mar0x/midi_splitter/images/midi_splitter.jpg

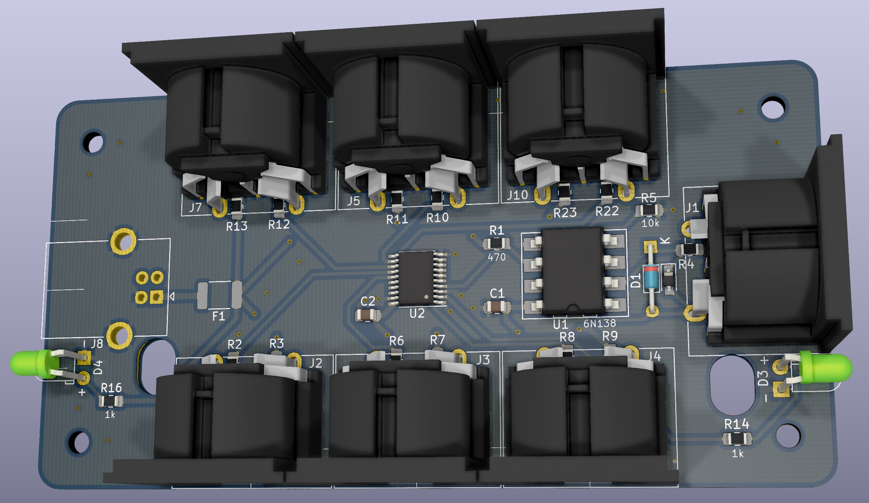
images/midi_splitter.jpg
