mar0x/midi_splitter/box/side_mill.jpg

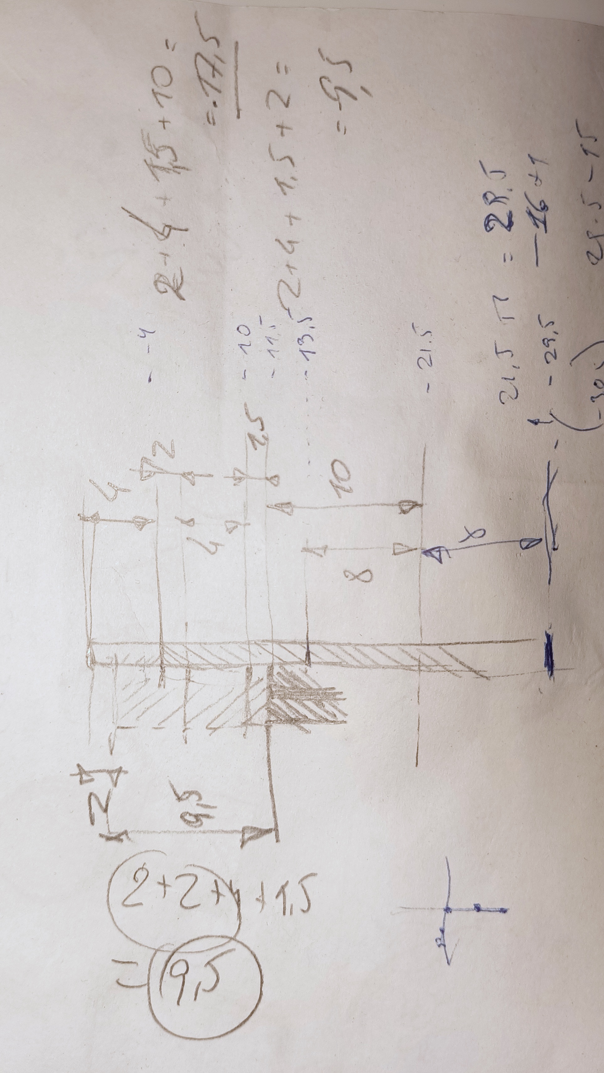
box/side_mill.jpg
