mar0x/midi_splitter/midi_splitter-bom.xlsx

Sheet: x6
id | q | ref | desc | size | Vendor |  | Order info
 |  |  |  |  | URL | code | # | date | price | count | shipping | cost | cost per item
G1032BA | 1 |  | Корпус для РЭА 101х54х41.7мм, пластик, черный, алюминиевая панель | 101х54х41.7mm | G1032BA (https://www.terraelectronica.ru/product/60026) | #60026 (https://www.terraelectronica.ru/product/60026) |  |  | 86.36 | 11 |  | 949.96 | 86.36
DS-210 | 0 | J6 | Гнездо питания 2,1х5,5мм на панель |  | DS-210B PBT NB (https://www.terraelectronica.ru/product/2584473) | #2584473 (https://www.terraelectronica.ru/product/2584473) |  |  | 10.40 | 10 | 322.00 | 426.00 | 0.00
 | 1 |  | Гнездо питания 2,0х5,5мм на панель |  | L-KLS1-DC-005A-2.0 (https://www.terraelectronica.ru/product/2200638) | #2200638 (https://www.terraelectronica.ru/product/2200638) |  |  | 6.30 | 10 |  | 63.00 | 6.30
DB102 | 1 | D2 | Диодный мост |  | DB102 (https://www.terraelectronica.ru/product/247793) | #247793 (https://www.terraelectronica.ru/product/247793) |  |  | 6.20 | 10 |  | 62.00 | 6.20
L7805 | 1 | U3 | Регулятор 5В, 1.5А | TO-220 | L7805 (https://www.terraelectronica.ru/product/62528) | #62528 (https://www.terraelectronica.ru/product/62528) |  |  | 12.70 | 10 |  | 127.00 | 12.70
SS-16-22 |  | C7 | Конд.эл. 22мкф 16В 4x7мм | 4x7mm | SS-16-22 (https://www.danomsk.ru/shop/5-kondensatory/88-kondensatory-elektroliticheskie/71209-ss-16-22-ss016m0022b1f-0407-4-7-16v-22uf-105-s-yageo/) | #71209 (https://www.danomsk.ru/shop/5-kondensatory/88-kondensatory-elektroliticheskie/71209-ss-16-22-ss016m0022b1f-0407-4-7-16v-22uf-105-s-yageo/) |  |  | 1.60 | 1 |  | 1.60 | 0.00
1N914 | 1 | D1 | Диод 75 мА 75В 5нс | DO-35 | 1N914 (https://www.terraelectronica.ru/product/284453) | #284453 (https://www.terraelectronica.ru/product/284453) |  |  | 0.56 | 10 |  | 5.60 | 0.56
6N138M | 1 | U1 | Оптопара с транзисторным выходом | SMD DIP-8 | 6N138M (https://www.aliexpress.com/item/10pcs-lot-6N135-6N136-6N137-6N138-6N139-DIP-8-SMD-8/32874392571.html) |  | #5009650439222510 (https://trade.aliexpress.ru/order_detail.htm?orderId=5009650439222510&orderSource=GlobalTrade) | 2021-04-05 | 9.85 | 20 | 199.27 | 396.19 | 19.81
74HC14 | 1 | U2 | Инвертирующий Триггер Шмитта | SOIC-14 | 74HC14D (https://www.terraelectronica.ru/product/34128) | #34128 (https://www.terraelectronica.ru/product/34128) |  |  | 6.60 | 10 |  | 66.00 | 6.60
RTW909080M | 7 | J1,J2,J3,J4,J5,J7,J10 | DIN connector 5 Pin DIN Female Jack Right Angle Panel Mount 90 Degree |  | DS-5-01 (https://aliexpress.ru/item/32402564814.html) |  | #5009651953842510 (https://trade.aliexpress.ru/order_detail.htm?orderId=5009651953842510&orderSource=GlobalTrade) | 2021-04-05 | 6.22 | 70 | 678.95 | 1114.49 | 111.45
PCB | 1 |  |  |  | JLCPCB |  |  |  | 38.17 | 10 | 556.52 | 938.22 | 93.82
220 Ohm | 13 | R2,R3,R4,R6,R7,R8,R9,R10,R11,R12,R13,R22,R23 | Чип резистор, 0.125Вт, 220 Ом, 1% | 0805 | CR-05FL7--220R (https://www.terraelectronica.ru/product/2782271) | #2782271 (https://www.terraelectronica.ru/product/2782271) |  |  | 0.13 | 130 |  | 16.90 | 1.69
470 Ohm | 1 | R1 | Чип резистор, 0.125Вт, 470 Ом, 1% | 0805 | CR-05FL7--470R (https://www.terraelectronica.ru/product/2782319) | #2782319 (https://www.terraelectronica.ru/product/2782319) |  |  | 0.13 | 10 |  | 1.30 | 0.13
10 kOhm | 3 | R5 | Чип резистор, 0.125Вт, 10 кОм, 1% | 0805 | RC0805FR-0710KL (https://www.terraelectronica.ru/product/358763) | #358763 (https://www.terraelectronica.ru/product/358763) |  |  | 0.17 | 30 |  | 5.10 | 0.51
1 kOhm | 3 | R14,R15,R16 | Чип резистор, 0.125Вт, 1 кОм, 1% | 0805 | CR0805-FX-1001ELF (https://www.terraelectronica.ru/product/813964) | #813964 (https://www.terraelectronica.ru/product/813964) |  |  | 0.28 | 30 |  | 8.40 | 0.84
0.1 uF | 5 | C1,C2,C4,C5,C6 | Кер.ЧИП конд. 0.1 мкФ, X7R, 50В, 10% | 0805 | CL21B104KBCNNNC (https://www.terraelectronica.ru/product/817075) | #817075 (https://www.terraelectronica.ru/product/817075) |  |  | 0.53 | 100 |  | 53.00 | 2.65
0.33uF | 1 | C3 | Кер.ЧИП конд. 0.33 мкФ, X7R, 50В, 10% | 0805 | CL21B334KBFNNNE (https://www.terraelectronica.ru/product/863571) | #863571 (https://www.terraelectronica.ru/product/863571) |  |  | 0.76 | 10 |  | 7.60 | 0.76
MF-MSMF050-2 | 1 | F1 | PTC Resettable Fuse | 1812 | MF-MSMF050-2 (https://www.terraelectronica.ru/product/186713) | #186713 (https://www.terraelectronica.ru/product/186713) |  |  | 2.30 | 10 |  | 23.00 | 2.30
DS1099 | 1 | J8 | USB Type-B |  | USBB-1J (https://www.terraelectronica.ru/product/2259339) | #2259339 (https://www.terraelectronica.ru/product/2259339) |  |  | 5.10 | 10 |  | 51.00 | 5.10
Micro USB | 1 | J9 | Micro USB Type-B |  | 10118194-0001LF (https://www.terraelectronica.ru/product/2543224) | #2543224 (https://www.terraelectronica.ru/product/2543224) |  |  | 20.00 | 1 |  | 20.00 | 20.00
PMV65XP,215 | 2 | Q2,Q3 | Транзистор MOSFET P-CH 20V 3.9A 76 mOhm | SOT-23-3 | PMV65XP.215 (https://www.terraelectronica.ru/product/212641) | #212641 (https://www.terraelectronica.ru/product/212641) |  |  | 3.20 | 20 |  | 64.00 | 6.40
SN74LVC1G125DBVR | 1 | U4 | Один буферный элемент с тремя состояниями на выходе | SOT-23-5 | SN74LVC1G125 (https://www.terraelectronica.ru/product/32503) | #32503 (https://www.terraelectronica.ru/product/32503) |  |  | 2.60 | 10 |  | 26.00 | 2.60
BC817 | 1 | Q1 | Транзистор биполярный NPN | SOT-23 | BC817.215 (https://www.terraelectronica.ru/product/338618) | #338618 (https://www.terraelectronica.ru/product/338618) |  |  | 0.88 | 10 |  | 8.80 | 0.88
100 kOhm | 1 | R21 | Чип резистор, 0.125Вт, 100 кОм, 1% | 0805 | RC0805FR-07100KL (https://www.terraelectronica.ru/product/359706) | #359706 (https://www.terraelectronica.ru/product/359706) |  |  | 0.18 | 20 |  | 3.60 | 0.18
 |  |  |  |  |  |  |  |  |  |  | 1756.74 | 4435.16 | 387.66

Sheet: x6-2
id | q | ref | desc | size | Vendor |  | Order info
 |  |  |  |  | URL | code | # | date | price | count | shipping | cost | cost per item
G1032BA | 1 |  | Корпус для РЭА 101х54х41.7мм, пластик, черный, алюминиевая панель | 101х54х41.7mm | G1032BA (https://www.terraelectronica.ru/product/60026) | #60026 (https://www.terraelectronica.ru/product/60026) | #07863451 (https://www.terraelectronica.ru/order/07863451) | 2022-03-22 | 224.00 | 21 |  | 4704.00 | 224.00
1N914 | 1 | D1 | Диод 75 мА 75В 5нс | DO-35 | 1n914 (https://www.chipdip.ru/product/1n914) |  | #8341083 (https://www.chipdip.ru/order/detail/8341083) | 2022-03-22 | 14.00 | 20 |  | 280.00 | 14.00
6N138M | 1 | U1 | Оптопара с транзисторным выходом | SMD DIP-8 |  | #32874392571 (https://www.aliexpress.ru/item/32874392571.html) | #5017385647722510 (https://trade.aliexpress.ru/order_detail.htm?orderId=5017385647722510&orderSource=GlobalTrade) | 2022-03-05 | 17.75 | 20 | 99.52 | 454.56 | 22.73
MM74HC540MTCX | 1 | U2 | Восемь буферных элементов, драйверов с тремя состояниями на выходе | TSSOP-20 | mm74hc540mtcx (https://www.chipdip.ru/product/mm74hc540mtcx) |  | #8338098 (https://www.chipdip.ru/order/detail/8338098) | 2022-03-21 | 26.00 | 21 |  | 546.00 | 26.00
RTW909080M | 7 | J1,J2,J3,J4,J5,J7,J10 | DIN connector 5 Pin DIN Female Jack Right Angle Panel Mount 90 Degree |  |  | #1005002547515126 (https://www.aliexpress.ru/item/1005002547515126.html) | #5017461801272510 (https://trade.aliexpress.ru/order_detail.htm?orderId=5017461801272510&orderSource=GlobalTrade) | 2022-03-14 | 22.02 | 300 | 1711.62 | 8316.43 | 194.05
PCB | 1 |  |  |  | Rezonit |  | #1517354 (https://service.rezonit.ru/orders/1168288) | 2022-03-22 |  | 20 |  | 7624.08 | 381.20
220 Ohm | 13 | R2,R3,R4,R6,R7,R8,R9,R10,R11,R12,R13,R22,R23 | Чип резистор, 0.125Вт, 220 Ом, 1% | 0805 | CR-05FL7--220R (https://www.terraelectronica.ru/product/2782271) | #2782271 (https://www.terraelectronica.ru/product/2782271) | #07863451 (https://www.terraelectronica.ru/order/07863451) | 2022-03-22 | 0.25 | 800 |  | 200.00 | 3.25
470 Ohm | 1 | R1 | Чип резистор, 0.125Вт, 470 Ом, 1% | 0805 | CR-05FL7--470R (https://www.terraelectronica.ru/product/2782319) | #2782319 (https://www.terraelectronica.ru/product/2782319) | #07863451 (https://www.terraelectronica.ru/order/07863451) | 2022-03-22 | 0.25 | 400 |  | 100.00 | 0.25
10 kOhm | 1 | R5 | Чип резистор, 0.125Вт, 10 кОм, 1% | 0805 | RC0805FR-0710KL (https://www.terraelectronica.ru/product/358763) | #358763 (https://www.terraelectronica.ru/product/358763) | #07863451 (https://www.terraelectronica.ru/order/07863451) | 2022-03-22 | 0.32 | 100 |  | 32.00 | 0.32
1 kOhm | 2 | R14,R16 | Чип резистор, 0.125Вт, 1 кОм, 1% | 0805 | CR0805-FX-1001ELF (https://www.terraelectronica.ru/product/813964) | #564131 (https://www.terraelectronica.ru/product/564131) | #07863451 (https://www.terraelectronica.ru/order/07863451) | 2022-03-22 | 0.28 | 30 |  | 8.40 | 0.56
0.1 uF | 2 | C1,C2 | Кер.ЧИП конд. 0.1 мкФ, X7R, 50В, 10% | 0805 | CC0805KRX7R9BB104 (https://www.terraelectronica.ru/product/251110) | #251110 (https://www.terraelectronica.ru/product/251110) | #07863451 (https://www.terraelectronica.ru/order/07863451) | 2022-03-22 | 0.66 | 400 |  | 264.00 | 1.32
L-13GD | 1 | D3 | Светодиод Flat Top зеленый 70° d=2мм 10мКд 568нМ |  | L-13GD (https://www.chipdip.ru/product/l-13gd) |  | #8341104 (https://www.chipdip.ru/order/detail/8341104) | 2022-03-22 | 29.00 | 70 |  | 2030.00 | 29.00
L-13ID | 1 | D4 | Flat Top красный |  |  | #307856 (https://www.terraelectronica.ru/product/307856) | #07863451 (https://www.terraelectronica.ru/order/07863451) | 2022-03-22 | 9.80 | 3 |  | 29.40 | 9.80
DS1099 | 1 | J8 | USB Type-B |  |  | #3638121 (https://www.terraelectronica.ru/product/3638121) | #07863451 (https://www.terraelectronica.ru/order/07863451) | 2022-03-22 | 11.30 | 40 |  | 452.00 | 11.30
MF-MSMF050-2 | 1 | F1 | PTC Resettable Fuse | 1812 |  | #4000903717748 (https://www.aliexpress.ru/item/4000903717748.html) |  | 2022-03-22 | 9.71 | 60 | 245.58 | 828.21 | 13.80
 |  |  |  |  |  |  |  |  |  |  | 2056.72 | 25869.08 | 931.59

Sheet: Orders
name | q | vendor | order date | order id | price | shipping | payment
PCB | 10 | jlcpcb.com | 2021-01-21 | #Y31-2346369A | 369.06 | 538.09 | 907.15
DS-5-01 MIDI | 70 | aliexpress.com | 2021-01-19 | #5008164770252510 (https://trade.aliexpress.ru/order_detail.htm?orderId=5008164770252510) | 1603.88 | 153.77 | 1757.65
6N138 SMD | 10 | aliexpress.com | 2021-01-19 | #5008164770232510 (https://trade.aliexpress.ru/order_detail.htm?orderId=5008164770232510) | 95.15 | 192.59 | 287.74
 |  | terraelectronica.ru | 2021-01-20 | #07251713 (https://www.terraelectronica.ru/order/07251713) | 1660.3 | 322 | 1982.3
total | 10 |  |  |  | 3728.39 | 1206.45 | 4934.84
PCB | 10 | jlcpcb.com | 2021-04-05 | #Y31-2346369A | 381.7 | 556.52 | 938.22
DS-5-01 MIDI | 70 | aliexpress.com | 2021-04-05 | #5009651953842510 (https://trade.aliexpress.ru/order_detail.htm?orderId=%205009651953842510) | 435.54 | 678.95 | 1114.49
6N138 SMD | 20 | aliexpress.com | 2021-04-05 | #5009650439222510 (https://trade.aliexpress.ru/order_detail.htm?orderId=%205009650439222510) | 196.92 | 199.27 | 396.19
 |  | terraelectronica.ru | 2021-04-05 | #07361016 (https://www.terraelectronica.ru/order/07361016) | 1739.24 | 322 | 2061.24
total | 10 |  |  |  | 2753.4 | 1756.74 | 4510.14
PCB | 10 | jlcpcb.com | 2022-02-01 | #Y31-2346369A | 387.29 | 549.18 | 936.47
DS-5-01 MIDI | 100 | aliexpress.com | 2022-02-01 | #5016623841712510 (https://trade.aliexpress.ru/order_detail.htm?orderId=5016623841712510&orderSource=GlobalTrade) | 797.1 | 590.3 | 1387.4
 |  | terraelectronica.ru | 2022-02-22 | #07796164 (https://www.terraelectronica.ru/order/07796164) | 505.44 | 236 | 741.44
 |  | terraelectronica.ru | 2022-02-25 | #07831475 (https://www.terraelectronica.ru/order/07831475) | 505.92 | 236 | 741.92
total | 10 |  |  |  | 1689.83 | 1611.48 | 3807.23
6N138M | 20 | aliexpress.com | 2022-03-05 | #5017385647722510 (https://trade.aliexpress.ru/order_detail.htm?orderId=5017385647722510&orderSource=GlobalTrade) | 355.04 | 99.52 | 454.56
DS-5-01 | 300 | aliexpress.com | 2022-03-14 | #5017461801272510 (https://trade.aliexpress.ru/order_detail.htm?orderId=5017461801272510&orderSource=GlobalTrade) | 6604.81 | 1711.62 | 8316.43
 |  | chipdip.ru | 2022-03-21 | #8338098 (https://www.chipdip.ru/order/detail/8338098) | 651 |  | 651
PCB | 20 | rezonit.ru | 2022-03-22 | #1517354 (https://service.rezonit.ru/orders/1168288) |  |  | 7624.08
 |  | chipdip.ru | 2022-03-22 | #8341083 (https://www.chipdip.ru/order/detail/8341083) | 4430 |  | 4430
 |  | terraelectronica.ru | 2022-03-22 | #07863451 (https://www.terraelectronica.ru/order/07863451) | 10778.4 | 236 | 11014.4
L-13GD | 70 | chipdip.ru | 2022-03-22 | #8341104 (https://www.chipdip.ru/order/detail/8341104) | 2030 |  | 2030
MF-MSMF050-2 | 60 | aliexpress.com | 2022-03-22 | #4000903717748 (https://www.aliexpress.ru/item/4000903717748.html) | 582.63 | 245.58 | 828.21
 |  |  |  |  |  |  | 35348.68
