mar0x/midi_splitter/kicad/power_adapter/power_adapter.step

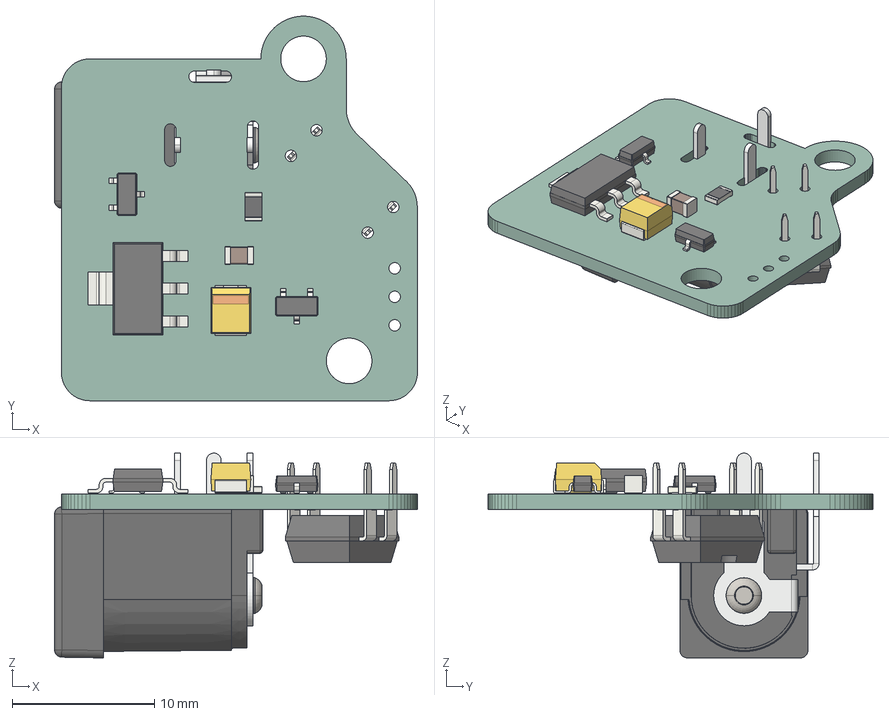
[picture p3: CAD file, 2024-02-03]
kicad/power_adapter/power_adapter.step
25.5 x 27.0 x 14.4 mm
SOT_223
SOT_23 x 2
C_0805_2012Metric
CP_EIA_3528_21_Kemet_B
R_0805_2012Metric
DIP-4_W7.62mm
DC Power Jack 5.5mm x 2.1mm
power_adapter PCB
