mar0x/midi_splitter/(threads)

Thread 1 (2021-12-07):

74AUC1G125 usage bug

DrAleks40, 2021-12-07:
В схеме использована 74AUC1G125 при питании +5В. Штатное питание этого чипа ВДВОЕ ниже, максимально допустимое 3.6V! Схема рабочая вообще???

DrAleks40, 2021-12-07:
Может просто отказаться от 5-6 каналов и пару элементов с 74HC14D пустить вместо 74AUC1G125???

mar0x, 2021-12-07:
Здравствуйте.
Это опечатка в схеме. Используется SN74LVC1G125. В [midi_splitter-bom.xlsx](https://github.com/mar0x/midi_splitter/blob/master/midi_splitter-bom.xlsx) указан правильный номинал.

Схему поправлю. Спасибо!

DrAleks40, 2021-12-07:
Ну или просто вместо SN74LVC1G125 поставить еще одну 74HC14D в режиме повторителя с упятеренным выходом? Дешевле кстати.

DrAleks40, 2021-12-07:
И еще попутно вопрос. Оптрон на AOT127 заменить можно? С изменением цоколевки ессно.

mar0x, 2021-12-07:
> Оптрон на AOT127 заменить можно?
Почитал [харктеристики](https://www.kondratev-v.ru/uploads_PDF/AOT127-AOT128/AOT127-AOT128.pdf). Судя по ограничению 1.6 В и задержке 10 мкс - нельзя.

mar0x, 2021-12-07:
Чем меньше, тем лучше. Важно, чтобы она не сильно отличалась на фронтах иначе будет искажение сигнала. MIDI передаётся на скорости 31250 bit/s т.е. 1 bit - 32 мкс. Разные устройства допускают различные отклонения (где-то 10%).
6N138 добавляет 1-2 мкс на восходящем фронте, на спадающем - меньше. Лучше переходить на 6N137 - он быстрее.

DrAleks40, 2021-12-07:
Хорошо, спасибо. Вместо SN74LVC1G125 поставить еще одну 74HC14D в режиме повторителя с упятеренным выходом можно?

mar0x, 2021-12-07:
Можно. Берите тогда сразу инвертированный сигнал с 8й ноги U2 - будет сразу ушестиритель. Царь-сплиттер на 11 выходов!

DrAleks40, 2021-12-07:
> с 8й ноги U2 - будет сразу ушестиритель.

Упс... А в чем тогда смысл канала на SN74LVC1G125, если JP1 не использовать?

mar0x, 2021-12-07:
Это доработка. Сначала был сплиттер x5, на свободное место добавили выход и буферный элемент. Этикетки "из старых запасов", их много напечатали не выбрасывать же... А джампер на случай, если будет сильное взаимное влияние и придётся поменять источник для U4 на выход из U2 (я не тестировал эту доработку до заказа платы).

DrAleks40, 2021-12-07:
Ясно. То есть от J10, U4 и т.п. можно вообще безболезненно отказаться. )) А вместо Q1 светодиод запитать от одного из выходов U2. )) Спасибо за разъяснения.

mar0x, 2022-05-10:
@DrAleks40 Приехали платы для упрощённой схемы "с одной микрухой и оптроном". Если интересно, могу продать комплект для сборки.

DrAleks40, 2022-05-10:
Интересно. Где глянуть эту вашу схему/плату? Почем комплект для сборки или одна голая плата?

Отправлено из мобильной Почты Mail.Ru

Вторник, 10 мая 2022 г., 12:18 +0300 от ***@***.***  ***@***.***>:
***@***.*** Приехали платы для упрощённой схемы "с одной микрухой и оптроном". Если интересно, могу продать комплект для сборки.
>—
>Reply to this email directly,  view it on GitHub , or  unsubscribe .
>You are receiving this because you were mentioned. Message ID:  <mar0x/midi_splitter/issues/1/1122140411 @ github . com>

mar0x, 2022-05-10:
Давайте перейдём в какой-нибудь мессенджер: +7 916 185-06-71

DrAleks40, 2022-05-10:
Не пользуюсь (кроме авито). В среду в какое время можете на коломенской или ближе к центру-северу? Я заранее позвоню тогда.

Отправлено из мобильной Почты Mail.Ru

Вторник, 10 мая 2022 г., 18:59 +0300 от ***@***.***  ***@***.***>:
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

mar0x, 2022-05-10:
В среду буду на Коломенской с 10:30 до 12:00. GitHub, мягко говоря, не для того подобных обсуждений. Ещё есть почта t79161850671@mail.ru.
Хотелось бы понять что Вас интересует (плата, весь набор и т.д.) шильдиков, напр. у меня сейчас нет.

Closed 2021-12-07.
