mar0x/midi_splitter/images/midi_splitter-pcb.pdf

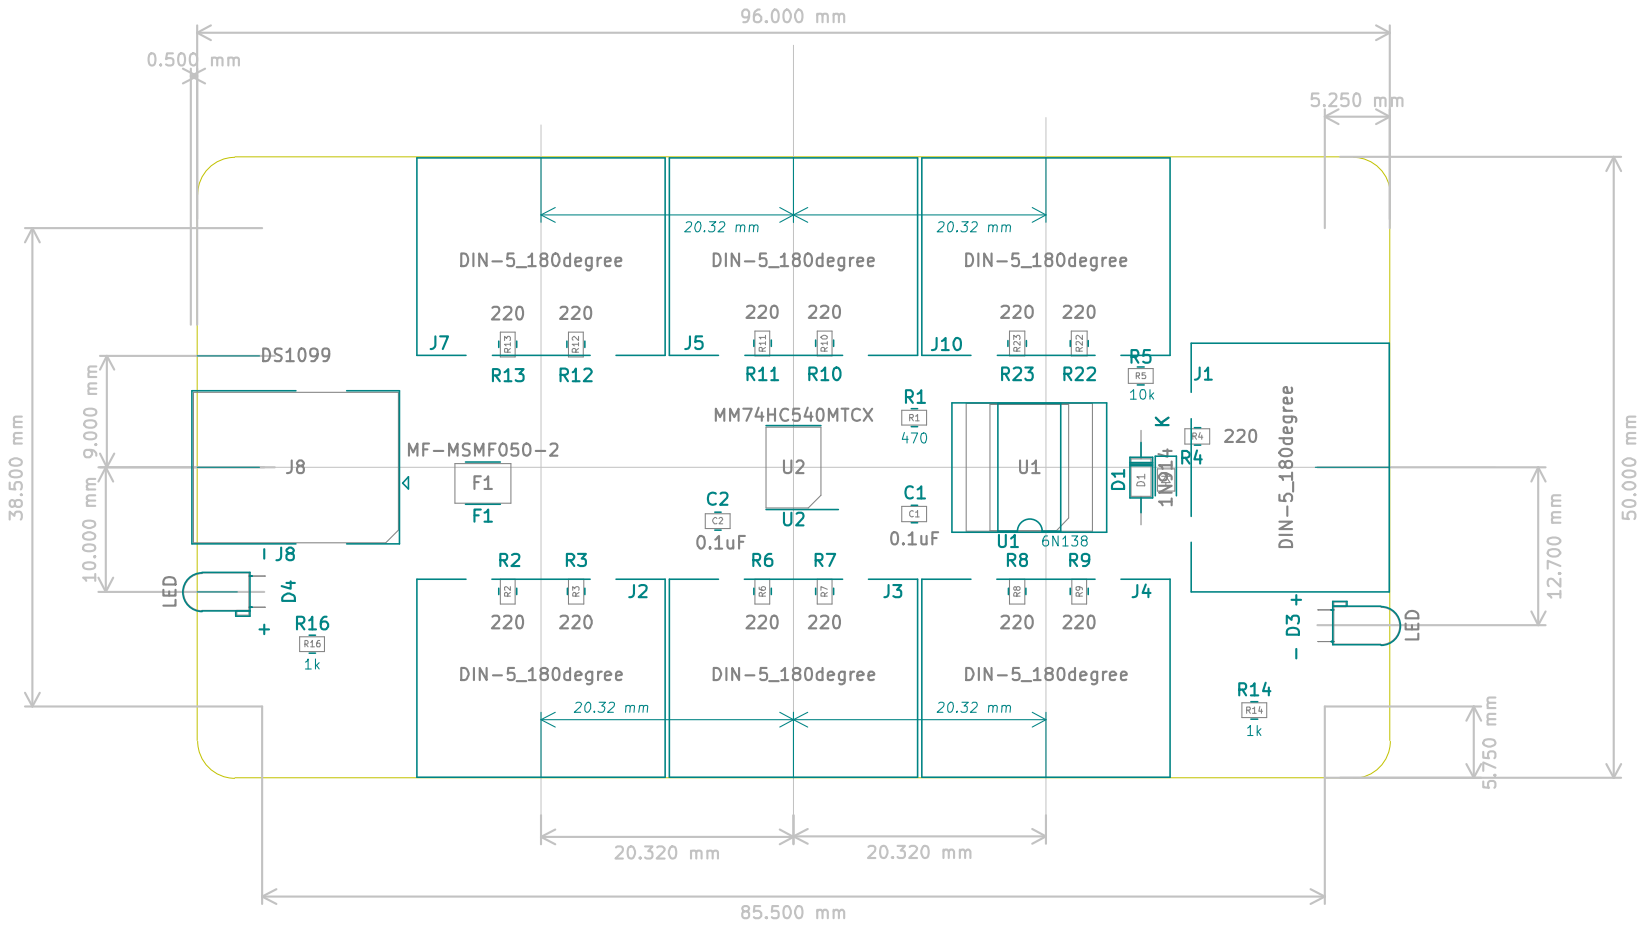
[picture p4: page 1]
