mar0x/midi_splitter/images/midi_splitter-schema.pdf

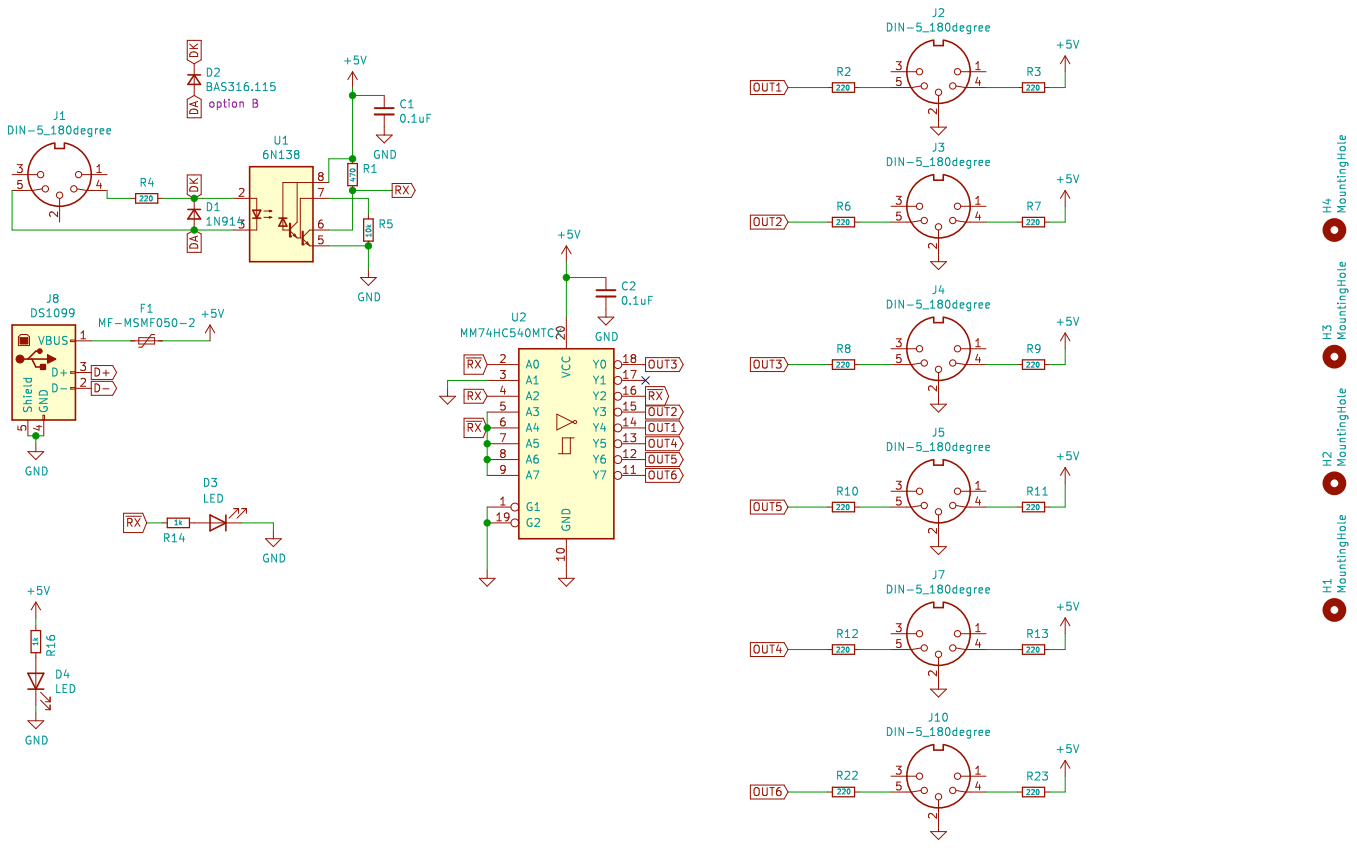
[picture p5: page 1]
