mar0x/midi_splitter/kicad/power_adapter/power_adapter.kicad_pcb

## KiCad design kicad/power_adapter/power_adapter.kicad_pcb (2024-02-12)

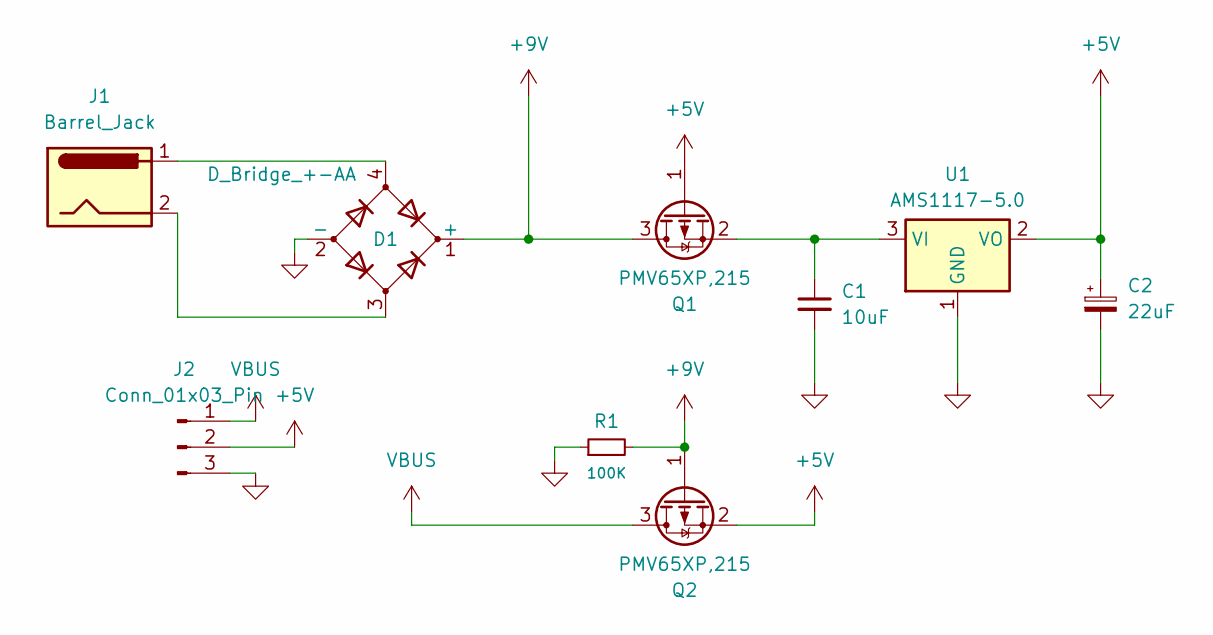
[picture p6: schematic power_adapter.kicad_sch]

Parts:
C1: 10uF; C_0805_2012Metric
C2: 22uF; CP_EIA-3528-21_Kemet-B
D1: D_Bridge_+-AA; Diode_Bridge_MBS
J1: Barrel_Jack; BarrelJack_Wuerth_6941xx301002
J2: Conn_01x03_Pin; PinHeader_1x03_P2.00mm_Vertical
Q1, Q2: PMV65XP,215; SOT-23
R1: 100K; R_0805_2012Metric
U1: AMS1117-5.0; SOT-223-3_TabPin2

Connections:
+5V: C2.1, J2.2, Q1.1 (G), Q2.2 (S), U1.2 (VO)
+9V: D1.1 (+), Q1.3 (D), Q2.1 (G), R1.2
GND: C1.2, C2.2, D1.2 (-), J2.3, R1.1, U1.1 (GND)
unnamed: D1.3, J1.2
unnamed: D1.4, J1.1
unnamed: C1.1, Q1.2 (S), U1.3 (VI)
VBUS: J2.1, Q2.3 (D)

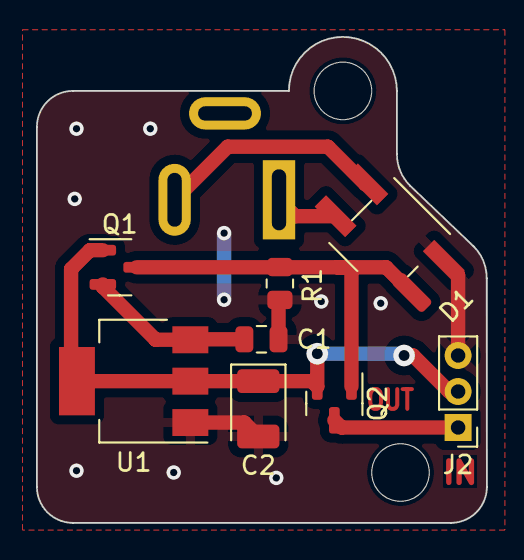
[picture p7: board power_adapter.kicad_pcb from above]

Board: 2 copper layers, 25.0 x 27.0 mm, 9 parts (1 on the bottom side), 7 nets.
