mar0x/midi_splitter/kicad/midi_splitter/midi_splitter.kicad_pcb

## KiCad design kicad/midi_splitter/midi_splitter.kicad_pcb (2024-02-03)

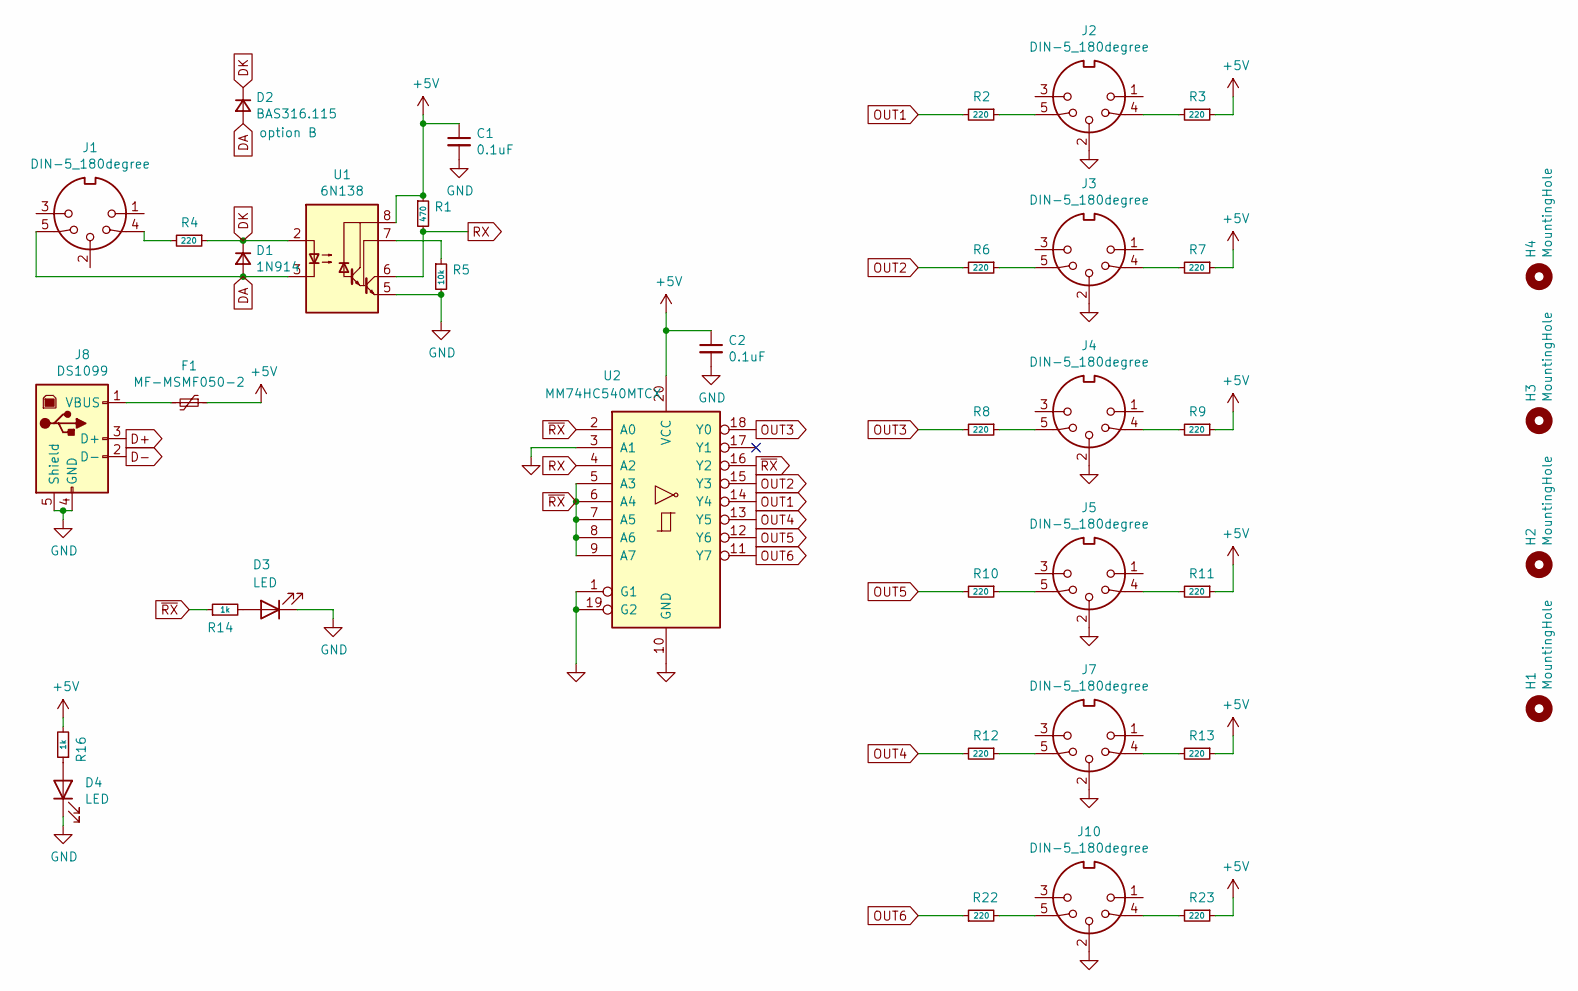
[picture p8: schematic midi_splitter.kicad_sch]

Parts:
C1, C2: 0.1uF; C_0805_2012Metric_Pad1.15x1.40mm_HandSolder
D1: 1N914; D_DO-34_SOD68_P7.62mm_Horizontal
D2: BAS316.115; D_SOD-323_HandSoldering
D3: LED; LED_D3.0mm_Horizontal_O1.27mm_Z10.0mm
D4: LED; LED_D3.0mm_Horizontal_O1.27mm_Z6.0mm
F1: MF-MSMF050-2; Fuse_1812_4532Metric_Pad1.30x3.40mm_HandSolder
H1, H2, H3, H4: MountingHole; MountingHole_2.7mm_M2.5_ISO14580
J1, J2, J3, J4, J5, J7, J10: DIN-5_180degree; DIN5MIDI-OOTDTY
J8: DS1099; USB_B_OST_USB-B1HSxx_Horizontal
R1: 470; R_0805_2012Metric_Pad1.15x1.40mm_HandSolder
R2, R3, R4, R6, R7, R8, R9, R10, R11, R12, R13: 220; R_0805_2012Metric_Pad1.15x1.40mm_HandSolder
R5: 10k; R_0805_2012Metric_Pad1.15x1.40mm_HandSolder
R14, R16: 1k; R_0805_2012Metric_Pad1.15x1.40mm_HandSolder
R22, R23: 220; R_0805_2012Metric_Pad1.20x1.40mm_HandSolder
U1: 6N138; DIP-8_W8.89mm_SMDSocket_LongPads
U2: MM74HC540MTCX; TSSOP-20_4.4x6.5mm_P0.65mm

Connections:
+5V: C1.1, C2.1, F1.1, R1.1, R3.1, R7.1, R9.1, R11.1, R13.1, R16.2, R23.1, U1.8 (VCC), U2.20 (VCC)
D+: J8.3 (D+)
D-: J8.2 (D-)
DA: D1.2 (A), D2.2 (A), J1.5, U1.3 (C2)
DK: D1.1 (K), D2.1 (K), R4.1, U1.2 (C1)
GND: C1.2, C2.2, D3.1 (K), D4.1 (K), J2.2, J3.2, J4.2, J5.2, J7.2, J8.4 (GND), J8.5 (Shield), J10.2, R5.2, U1.5 (GND), U2.1 (G1), U2.3 (A1), U2.10 (GND), U2.19 (G2)
unnamed: D3.2 (A), R14.2
unnamed: D4.2 (A), R16.1
unnamed: F1.2, J8.1 (VBUS)
unnamed: J1.4, R4.2
unnamed: J2.4, R3.2
unnamed: J2.5, R2.1
unnamed: J3.4, R7.2
unnamed: J3.5, R6.1
unnamed: J4.4, R9.2
unnamed: J4.5, R8.1
unnamed: J5.4, R11.2
unnamed: J5.5, R10.1
unnamed: J7.4, R13.2
unnamed: J7.5, R12.1
unnamed: J10.4, R23.2
unnamed: J10.5, R22.2
unnamed: R5.1, U1.7 (VO1)
OUT1: R2.2, U2.14 (Y4)
OUT2: R6.2, U2.15 (Y3)
OUT3: R8.2, U2.18 (Y0)
OUT4: R12.2, U2.13 (Y5)
OUT5: R10.2, U2.12 (Y6)
OUT6: R22.1, U2.11 (Y7)
RX: R1.2, U1.6 (VO2), U2.4 (A2)
~RX: R14.1, U2.2 (A0), U2.5 (A3), U2.6 (A4), U2.7 (A5), U2.8 (A6), U2.9 (A7), U2.16 (Y2)

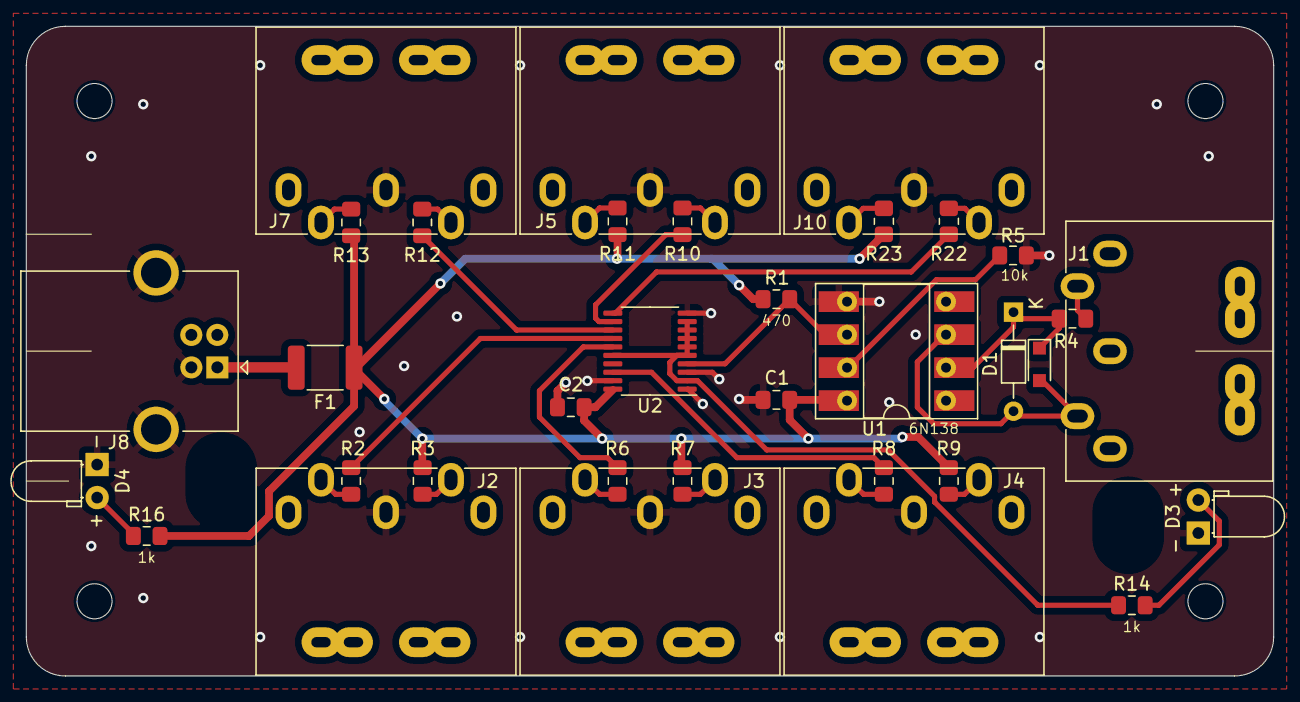
[picture p9: board midi_splitter.kicad_pcb from above]

Board: 2 copper layers, 96.0 x 50.0 mm, 38 parts (0 on the bottom side), 29 nets.
