mar0x/midi_splitter/(commit log)

2019-02-27 Adding URLs to BOM.
2019-02-27 Fixing power plug connection.
    [MIDISplitter-hc14-pcb-DIN-50x96.fzz]
2019-03-01 Introducing images and gerber files.
    [MIDISplitter-lower_contour.gm1, MIDISplitter-lower_copperBottom.gbl, MIDISplitter-lower_copperTop.gtl, MIDISplitter-lower_maskBottom.gbs, MIDISplitter-lower_maskTop.gts, MIDISplitter-lower_silkBottom.gbo, MIDISplitter-lower_silkTop.gto, MIDISplitter-upper_contour.gm1]
2020-10-12 KiCad board added.
    [bom.xlsx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]
2020-10-17 Removing old version.
    [MIDISplitter-hc14-pcb-DIN-50x96.fzz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]
2021-01-21 Adding 6th MIDI OUT and USB power input.
    [bom.xlsx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]
2021-12-07 Updating U4 for SN74LVC1G125.
    This closes #1 issue on GitHub.
    [midi_splitter.sch]
2021-12-10 Updating U4 in generated files.
    [midi_splitter-bom.xlsx, midi_splitter.kicad_pcb]
2022-03-05 Updating BOM.
    [midi_splitter-bom.xlsx]
2022-03-23 Reducing number of components.
    - removing 9-12v power supply option;
    - replacing 74hc14 with 74hc540;
    [midi_splitter-bom.xlsx, midi_splitter.kicad_pcb, midi_splitter.sch]
2022-03-23 Updating MIDI socket 3D model.
    [midi_splitter.kicad_pcb]
2022-07-23 Making box 1mm lower.
2023-10-18 Moving kicad project into directory
    [midi_splitter.kicad_pcb, midi_splitter.sch]
2023-10-18 Start version with TRS
    [midi_splitter_trs.kicad_pcb, midi_splitter_trs.kicad_sch]
2024-02-02 9V Power adapter board introduced
    [power_adapter.kicad_pcb, power_adapter.kicad_sch]
2024-02-03 Adjusting path to 3D models
    [midi_splitter.kicad_pcb, power_adapter.kicad_pcb]
2024-02-03 Upgrading to KiCAD 7
    [midi_splitter.kicad_pcb, midi_splitter.kicad_sch, midi_splitter.sch]
2024-02-03 Improving power adapter
    [midi_splitter.kicad_pcb, power_adapter.kicad_pcb, power_adapter.kicad_sch, power_adapter.step]
2024-02-09 Power adapter fixes
    [power_adapter.kicad_pcb]
2024-02-12 Automatic box probe
2024-02-12 Speed up milling, add one more power hole
